IVIanyou/STM32-BlackPill-FanPumpController/README.md

# STM32-BlackPill-FanPumpController
## Introduction
 This Project is about building a controller for PWM fans and pumps with a display, mounting bracket and water temperature sensor. It utilizes an STM32 BlackPill Board (stm32f103c8), which is programmed with STM32duino. This eliminates any drivers and thus load on the system itself and also doesn't require a sensor-header on the motherboard.
 
## 1. Parts Selection
The controller needs to do 3 different tasks:
 - Control at least 2 PWM fans/pumps
 - Read the temperature from a watercooling temperature sensor
 - Display the information on a little display
 
The chosen Microcontroller is an stm32f103c8, because it is very inexpensive and has more than enough performance for this application. It has 5 5V tolerant (important) PWM Pins and a 16-bit ADC (analog to digital converter).

As a display, the SSD1306 was chosen for very similar reasons and its fitting size.

The temperature sensor and watercooling pump in this case is a Barrow TCWD-V1 and SPB17-TM, but any PWM pump and temperature sensor (thermistor type) with a datasheet should work.

## 2. Planning and Breadboard-Mockup

### PWM Signal Generation

The PWM signal that will be generated has to have a 5V amplitude and a 25 kHz frequency. The information in the signal is transferred through the Duty Cycle of the signal. 
The general specifications and tolerance windows are published by Noctua in the following white paper: 
https://noctua.at/pub/media/wysiwyg/Noctua_PWM_specifications_white_paper.pdf

Because this microcontroller does not have a high enough logic level to generate this signal by itself (only 3.3V), a pullup-resistor connected to a 5V line has to be used. With the pins operating in open drain mode, it generates the required 5V PWM signal.

( Explanation open drain: https://forum.digikey.com/t/what-does-open-drain-mean/716 )

Which pins are PWM capable, 5V tolerant and how much current they can sink can be seen in this detailed pinout diagram (and/or the datasheet):
https://github.com/Jedzia/LabDocuments/blob/master/ARM/Black_Pill_Pinout-adv.png

8 mA is the recommendet current, so with a 1 kOhm resistor there is a 5 mA pullup-current, which is almost perfect.

The display is controlled by the I2C Bus, so it just needs to be connected to power and an SCL and SDA Pin and give the sketch the correct address. The address can be obtained either from the datasheet or by using this sketch: https://learn.adafruit.com/scanning-i2c-addresses/arduino

### Breadboard Mockup PWM

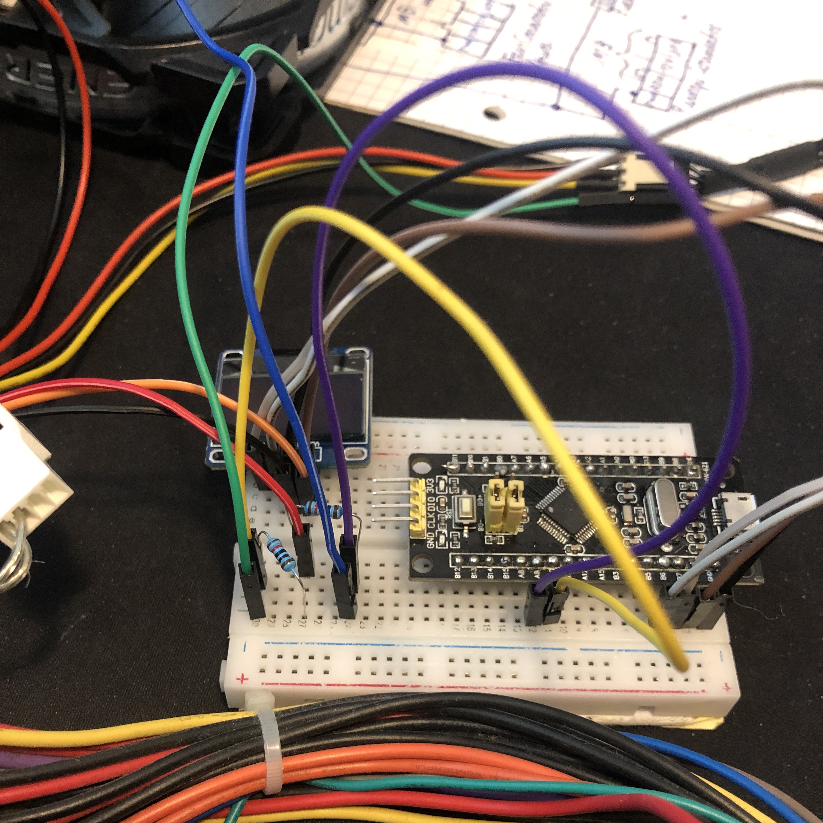
[picture p1: Images/Mockup_PWM_1.jpg]
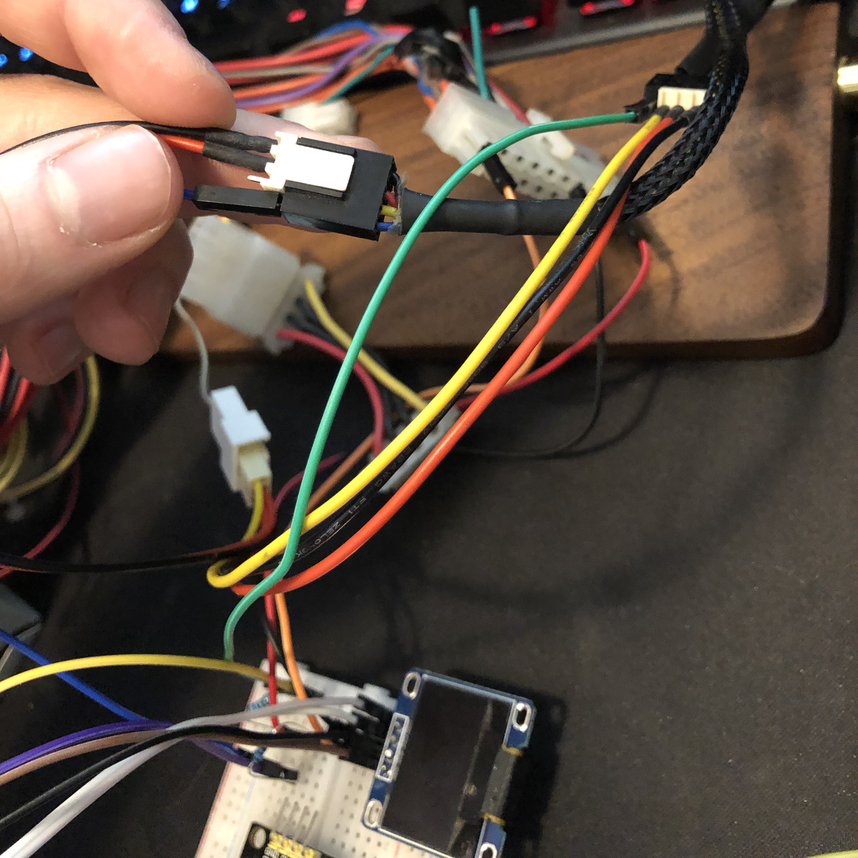
[picture p2: Images/Mockup_PWM_2.jpg]
   

### Reading the Temperature Sensor

The temperature sensor is a thermistor, so it measures the temperature by changing its resistance value. The values for this sensor are listed on its product page. To measure resistance with a microcontroller a voltage divider is used in which the voltage dropoff can be measured. Details and the kind of circuit that was used can be found in the following article: https://www.circuitbasics.com/arduino-thermistor-temperature-sensor-tutorial/

### Breadboard Mockup with Temperature Sensor

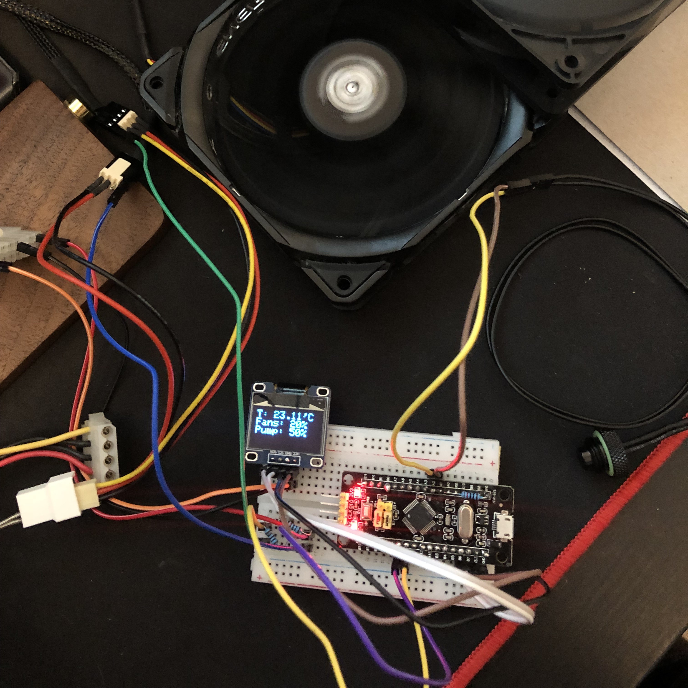
[picture p3: Images/Mockup_final_1.jpg]
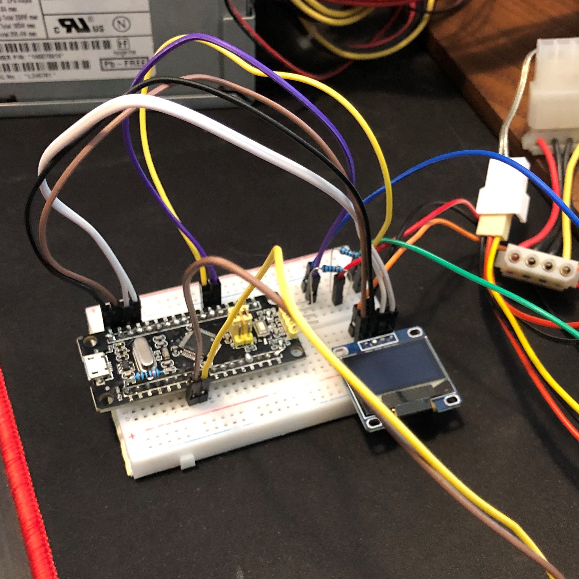
[picture p4: Images/Mockup_final_2.jpg]
   

## 3. Final Circuitry

The final circuitry can be seen in the following circuit diagram (created in LTspice):

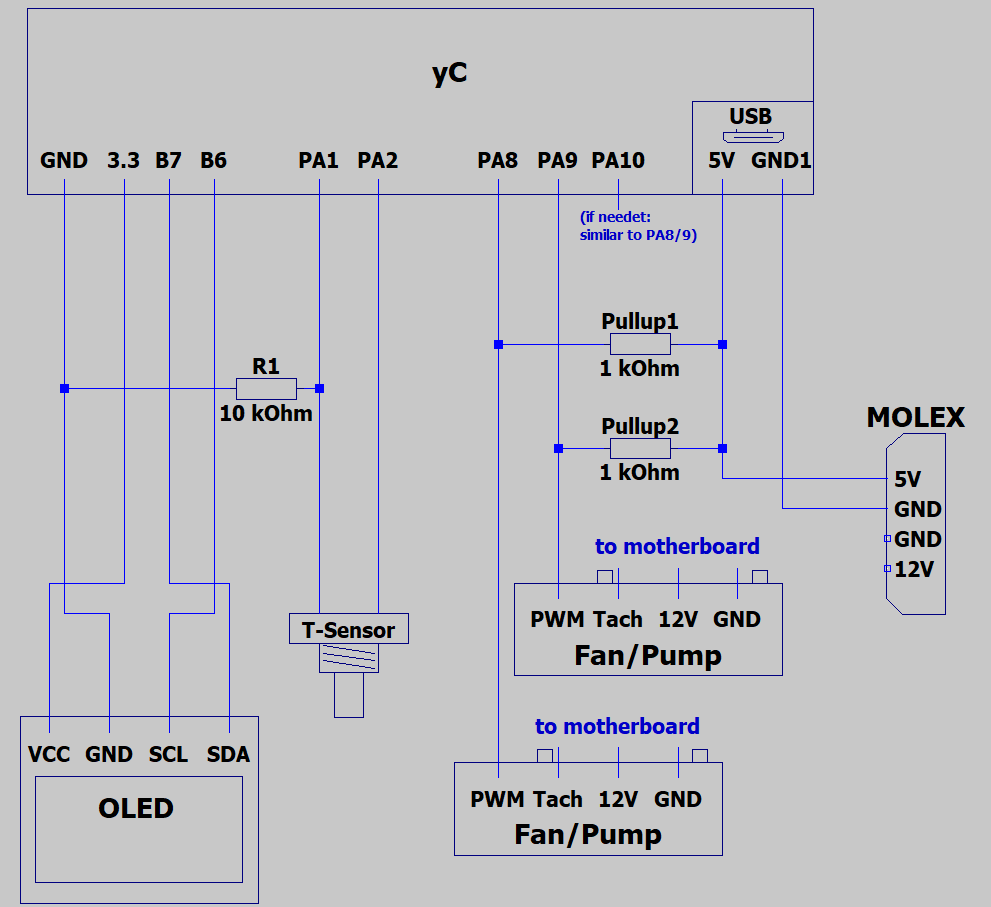
[picture p5: Images/Circuitry.png]


The pullup resistors and connections to the Molex and USB connectors were directly soldered into one cable. The resistor for the voltage divider was directly soldered on top of the microcontroller from the pin to a ground connection.

The Tachometer signal can be read as well, which is implemented in Version 1 of the code. The problem is, that outputting the PWM signals generates way too much interference and cant be easily filtered by software. It works perfectly without the PWM pins connected, but as soon as they are plugged in, the signal becomes a mess. A fitting capacitor would have to be used to read it with the microcontroller. Reading it with the motherboard however has some perks in itself, because you can have low RPM warnings for example.

## 4. Mounting Bracket

As the Material for the mounting bracket, acrylic sheets with a thickness of 2,7 mm were chosen. These should be strong enough, nonconductive and can be fused together very strongly with cyanoacrylate (super glue). 

After making a quick technical drawing by hand (Technical_Drawing.pdf), the acrylic sheets were scored with a razor blade and broken off to size. Then the holes were drilled and after sanding the edges, the sheets were glued together. To mount the OLED display, an old fan connector was glued to the bottom, in which the pins fit in and hold the screen securely.

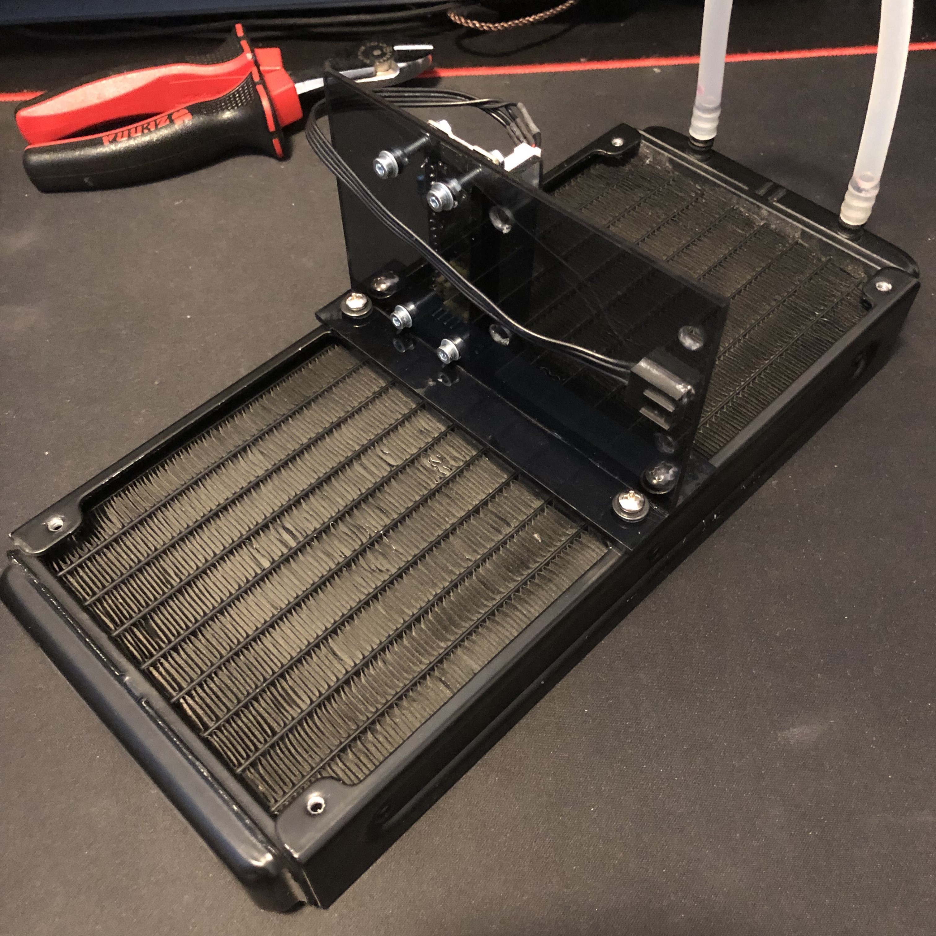
[picture p6: Images/Bracket_1.jpg]
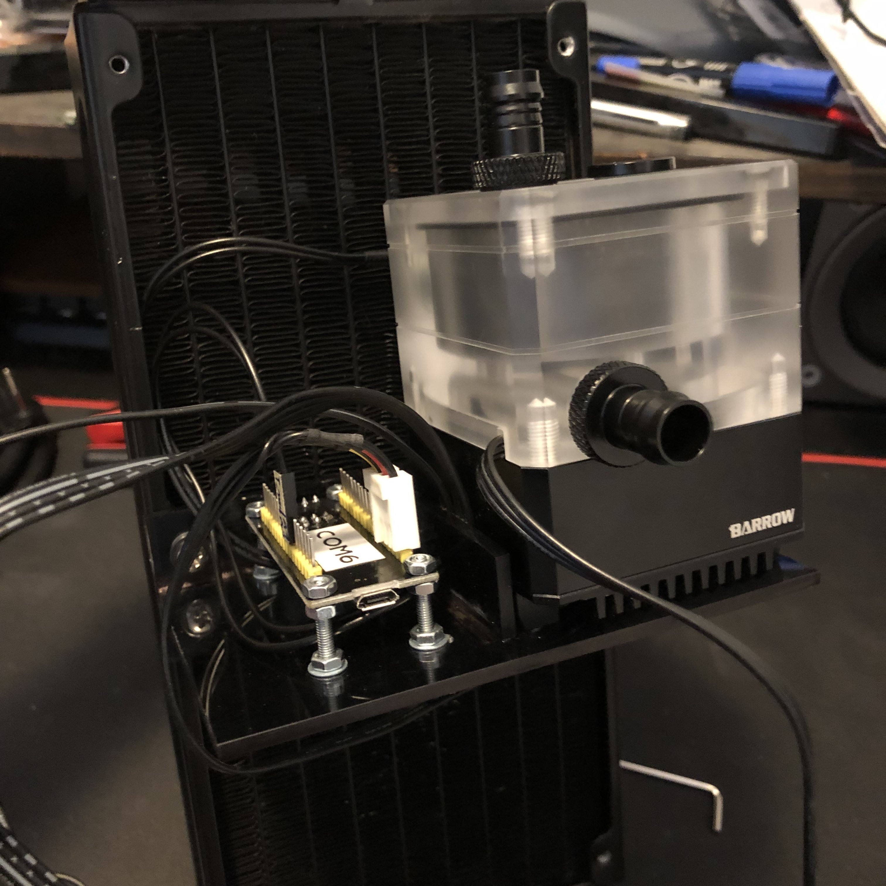
[picture p7: Images/Bracket_2.jpg]
    

## 5. Code

The code itself is explained in comments and should be easy to understand. 

Arduino in combination with STM32duino was used for programming the microcontroller:
https://github.com/stm32duino

An HID bootloader was used as the upload method, because it is way quicker than any adapter.
https://youtu.be/Myon8H111PQ

## 6. The Finished Project

The finished build works flawlessly and looks amazing in my opinion. The fans and pump stay really quiet in short and bursty workloads and only ramp up when they need to. The colour of the display also matches the interior lighting almost perfectly. I can really recommend building such a project, as it is very useful and you learn a ton on the way.

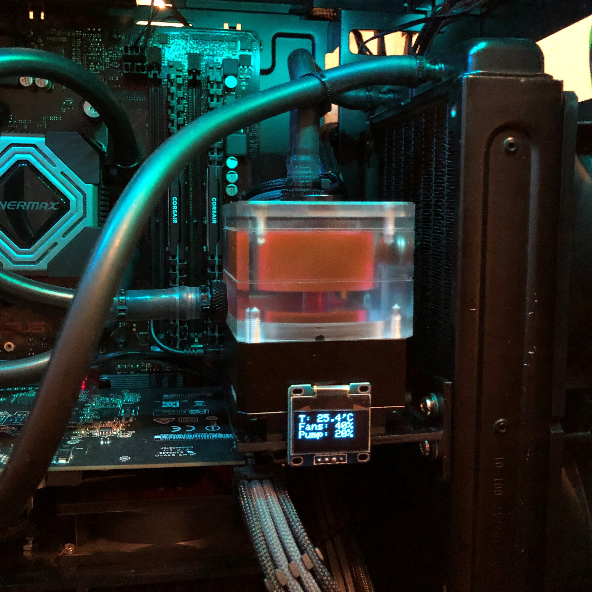
[picture p8: Images/Finished_2.jpg]
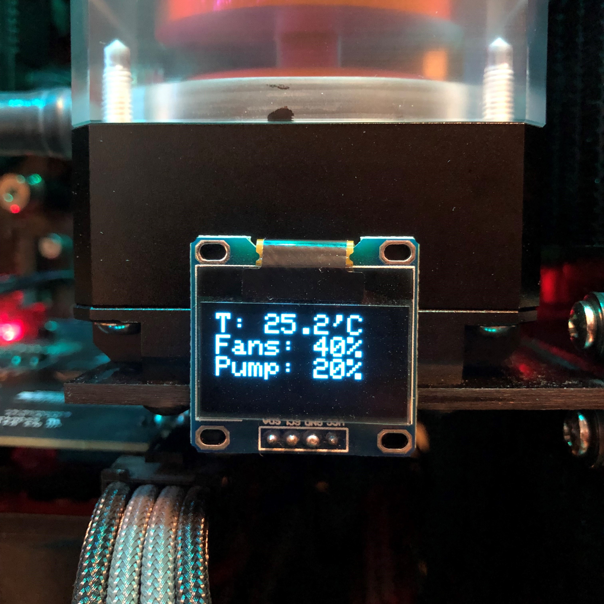
[picture p9: Images/Finished_CloseUp.jpg]
   

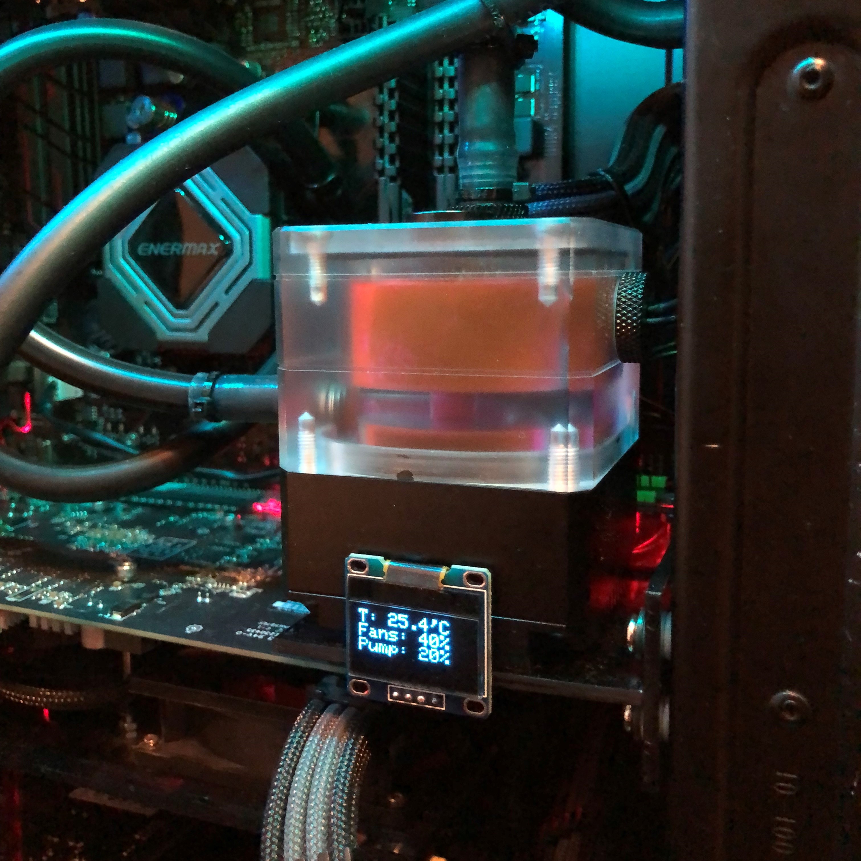
[picture p10: Images/Finished_1.jpg]
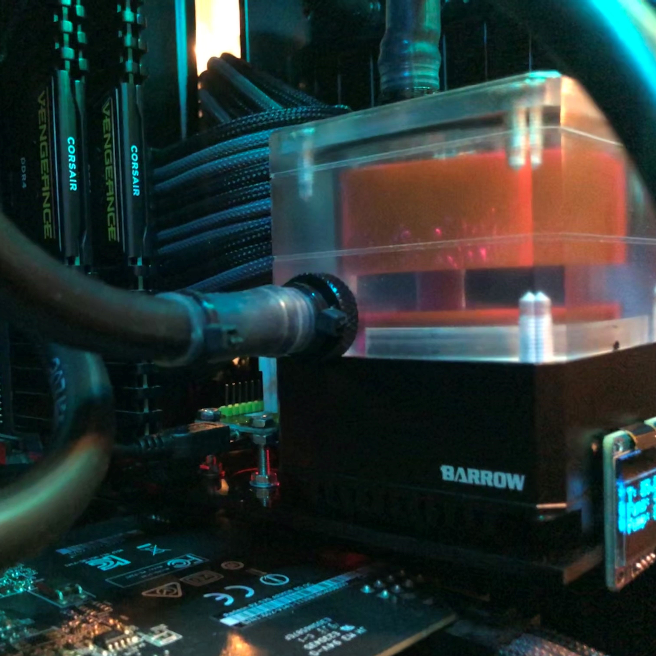
[picture p11: Images/Finished_3.jpg]
   

## Inspiration: 

https://www.youtube.com/@OptimumTech

https://youtu.be/Toramr9PfOE
