IVIanyou/STM32-BlackPill-FanPumpController/Technical_Drawing.pdf

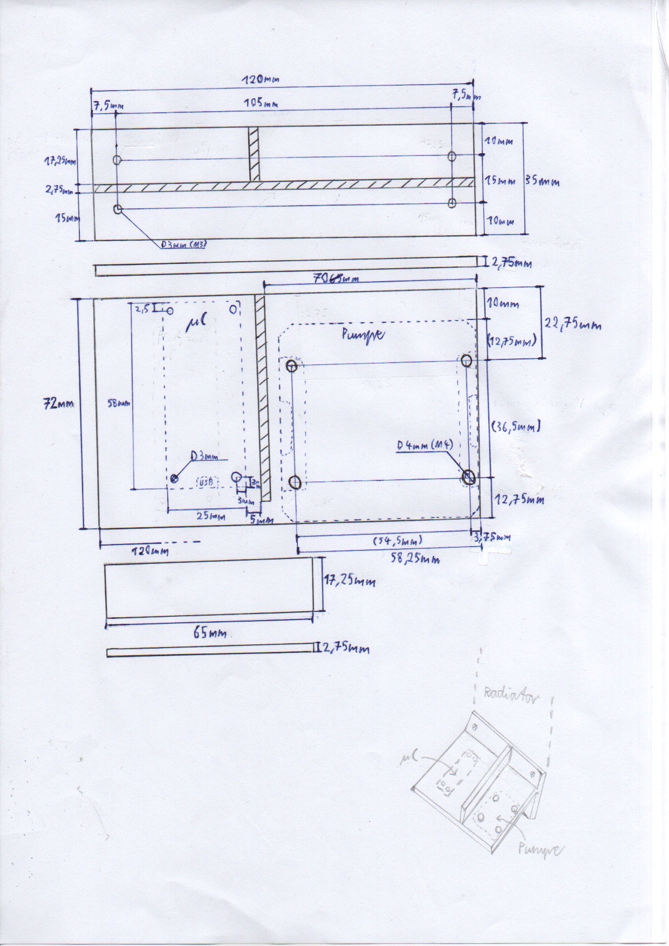
[picture p12: page 1]
