IVIanyou/STM32-BlackPill-FanPumpController/Images/Finished_PC.jpg

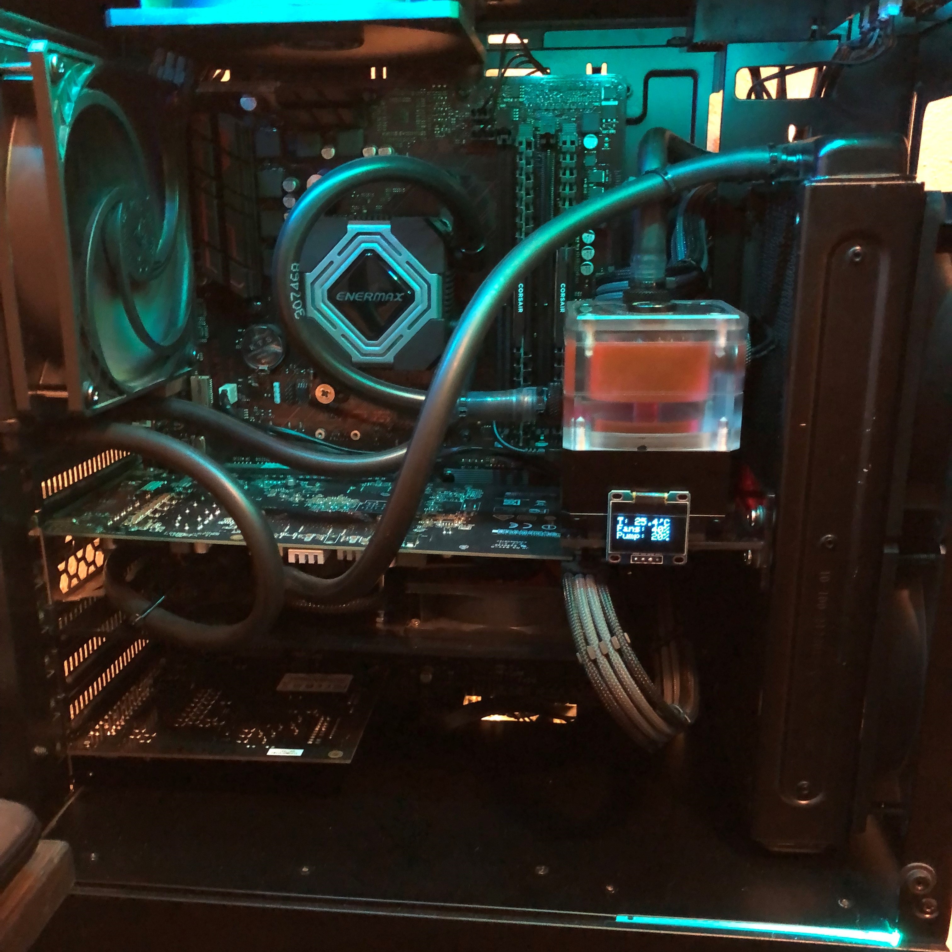
Images/Finished_PC.jpg
