IVIanyou/STM32-BlackPill-FanPumpController/Circuitry/Circuitry_LTspice.asc

Pullup1: EuropeanResistor; 1 kOhm
Pullup2: EuropeanResistor; 1 kOhm
R1: EuropeanResistor; 10 kOhm
X1: yC
X2: OLED
X3: tempsens
X4: MOLEX
X5: 4Pin_Fan
X6: 4Pin_Fan
to motherboard
to motherboard
(if needet: 
similar to PA8/9)
