IVIanyou/STM32-BlackPill-FanPumpController/(commit log)

2023-03-16 Circuit File and Image added
2023-03-16 Circuitry and bracket added
